Outurnate/tesla-coil/(list of files, cad)

Other CAD files:
model/primary_coil_form_b.scad
