Outurnate/tesla-coil/pcb/synth.kicad_pcb

## KiCad design pcb/synth.kicad_pcb (2023-07-12)

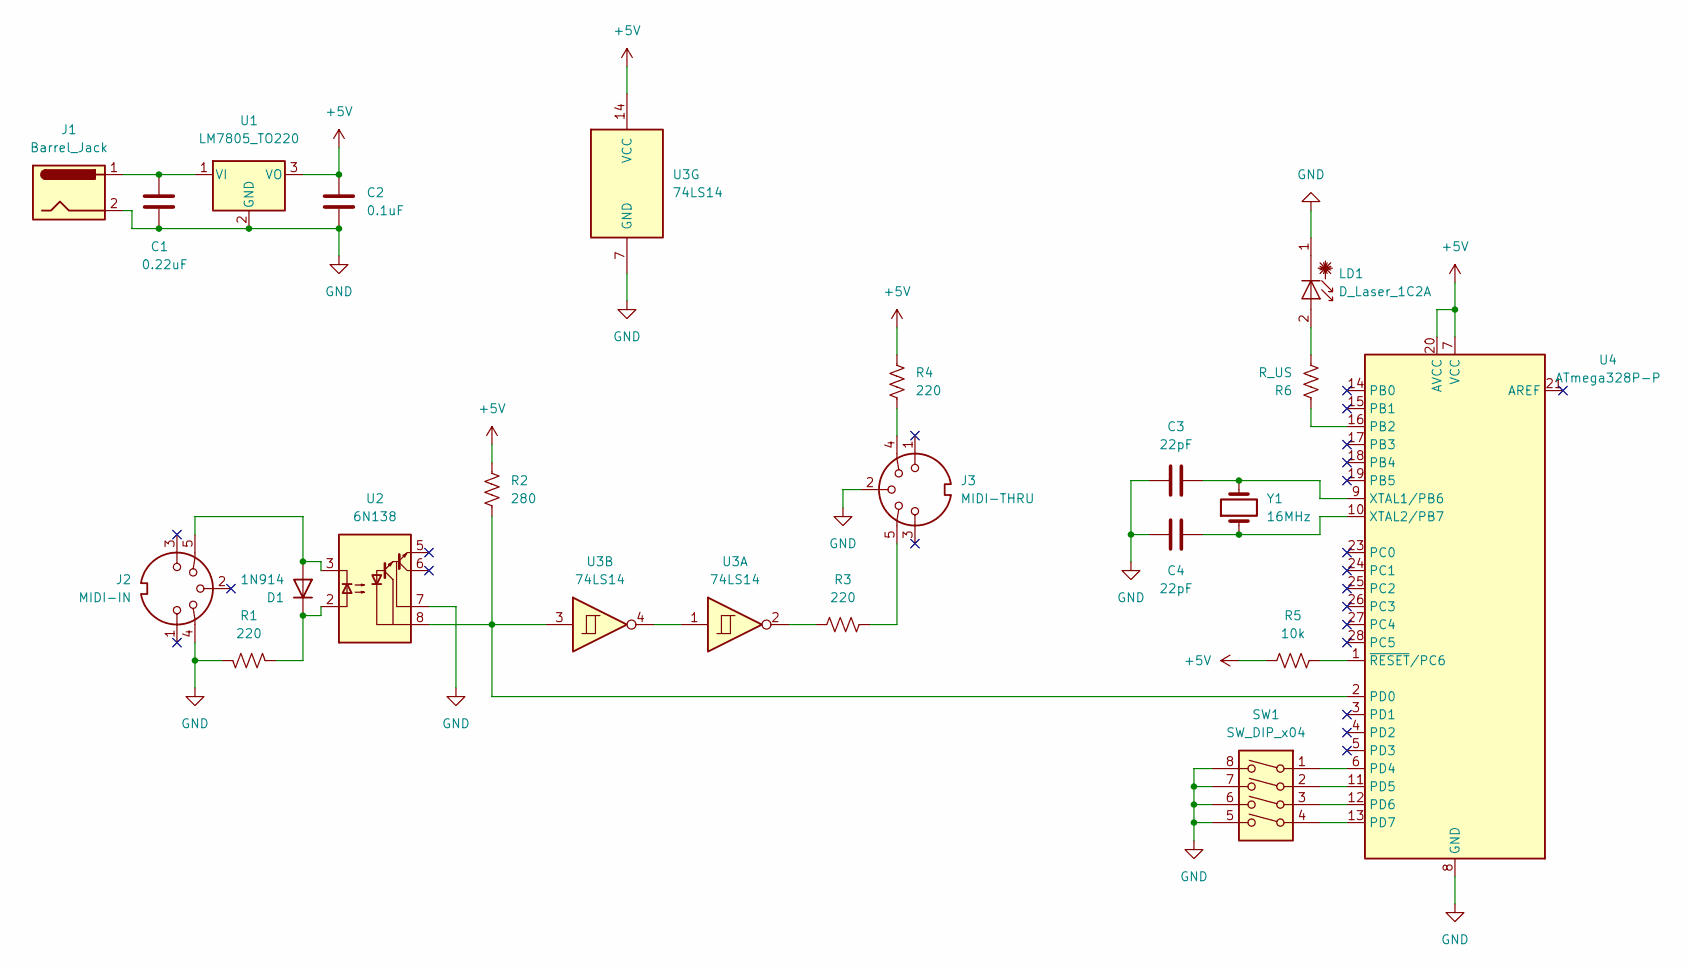
[picture p1: schematic synth.kicad_sch]

Parts:
C1: 0.22uF; C_Disc_D5.0mm_W2.5mm_P2.50mm
C2: 0.1uF; C_Disc_D5.0mm_W2.5mm_P2.50mm
C3, C4: 22pF; C_Disc_D5.0mm_W2.5mm_P2.50mm
D1: 1N914; D_DO-35_SOD27_P7.62mm_Horizontal
J1: Barrel_Jack; CUI_PJ-037A
J2: MIDI-IN; CUI_SDS-50J
J3: MIDI-THRU; CUI_SDS-50J
LD1: D_Laser_1C2A; PinHeader_1x02_P2.54mm_Vertical
R1, R3, R4: 220; R_Axial_DIN0207_L6.3mm_D2.5mm_P10.16mm_Horizontal
R2: 280; R_Axial_DIN0207_L6.3mm_D2.5mm_P10.16mm_Horizontal
R5: 10k; R_Axial_DIN0207_L6.3mm_D2.5mm_P10.16mm_Horizontal
R6: R_US; R_Axial_DIN0207_L6.3mm_D2.5mm_P10.16mm_Horizontal
SW1: SW_DIP_x04; SW_DIP_SPSTx04_Slide_9.78x12.34mm_W7.62mm_P2.54mm
U1: LM7805_TO220; TO-220-3_Vertical
U2: 6N138; DIP-8_W7.62mm_Socket
U3: 74LS14; DIP-14_W7.62mm_Socket
U4: ATmega328P-P; DIP-28_W7.62mm_Socket
Y1: 16MHz; Crystal_HC49-U_Vertical

Connections:
+5V: C2.1, R2.1, R4.1, R5.2, U1.3 (VO), U3.14 (VCC), U4.7 (VCC), U4.20 (AVCC)
GND: C1.2, C2.2, C3.2, C4.1, J1.2, J2.4, J3.2, LD1.1 (K), R1.2, SW1.5, SW1.6, SW1.7, SW1.8, U1.2 (GND), U2.7 (VO1), U3.7 (GND), U4.8 (GND), U4.22 (GND)
unnamed: C1.1, J1.1, U1.1 (VI)
unnamed: C3.1, U4.9 (XTAL1/PB6), Y1.2
unnamed: C4.2, U4.10 (XTAL2/PB7), Y1.1
unnamed: D1.1 (K), R1.1, U2.2 (C1)
unnamed: D1.2 (A), J2.5, U2.3 (C2)
unnamed: J3.4, R4.2
unnamed: J3.5, R3.1
unnamed: LD1.2 (A), R6.2
unnamed: R2.2, U2.8 (VCC), U3.3, U4.2 (PD0)
unnamed: R3.2, U3.2
unnamed: R5.1, U4.1 (~RESET/PC6)
unnamed: R6.1, U4.16 (PB2)
unnamed: SW1.1, U4.6 (PD4)
unnamed: SW1.2, U4.11 (PD5)
unnamed: SW1.3, U4.12 (PD6)
unnamed: SW1.4, U4.13 (PD7)
unnamed: U3.1, U3.4

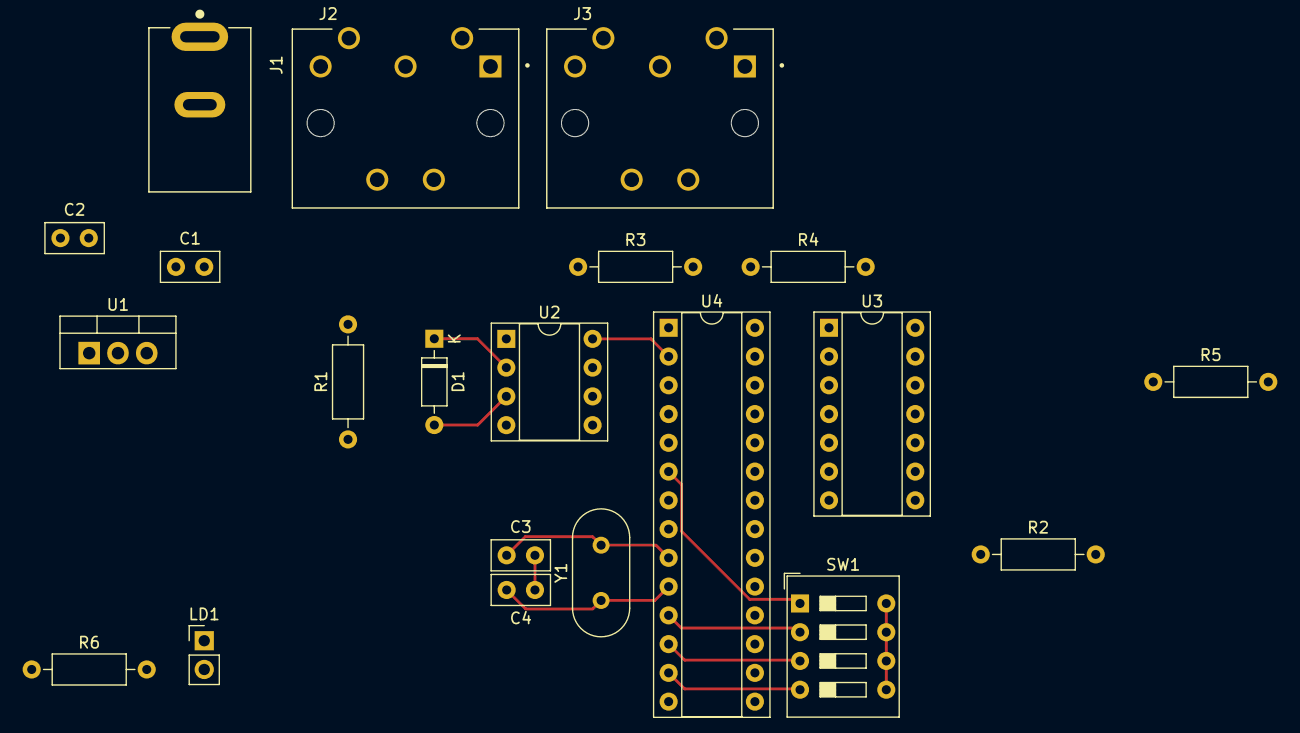
[picture p2: board synth.kicad_pcb from above]

Board: 2 copper layers, 21 parts (0 on the bottom side), 19 nets.
