Outurnate/tesla-coil/pcb/vdoubler.kicad_pcb

## KiCad design pcb/vdoubler.kicad_pcb (2023-07-12)

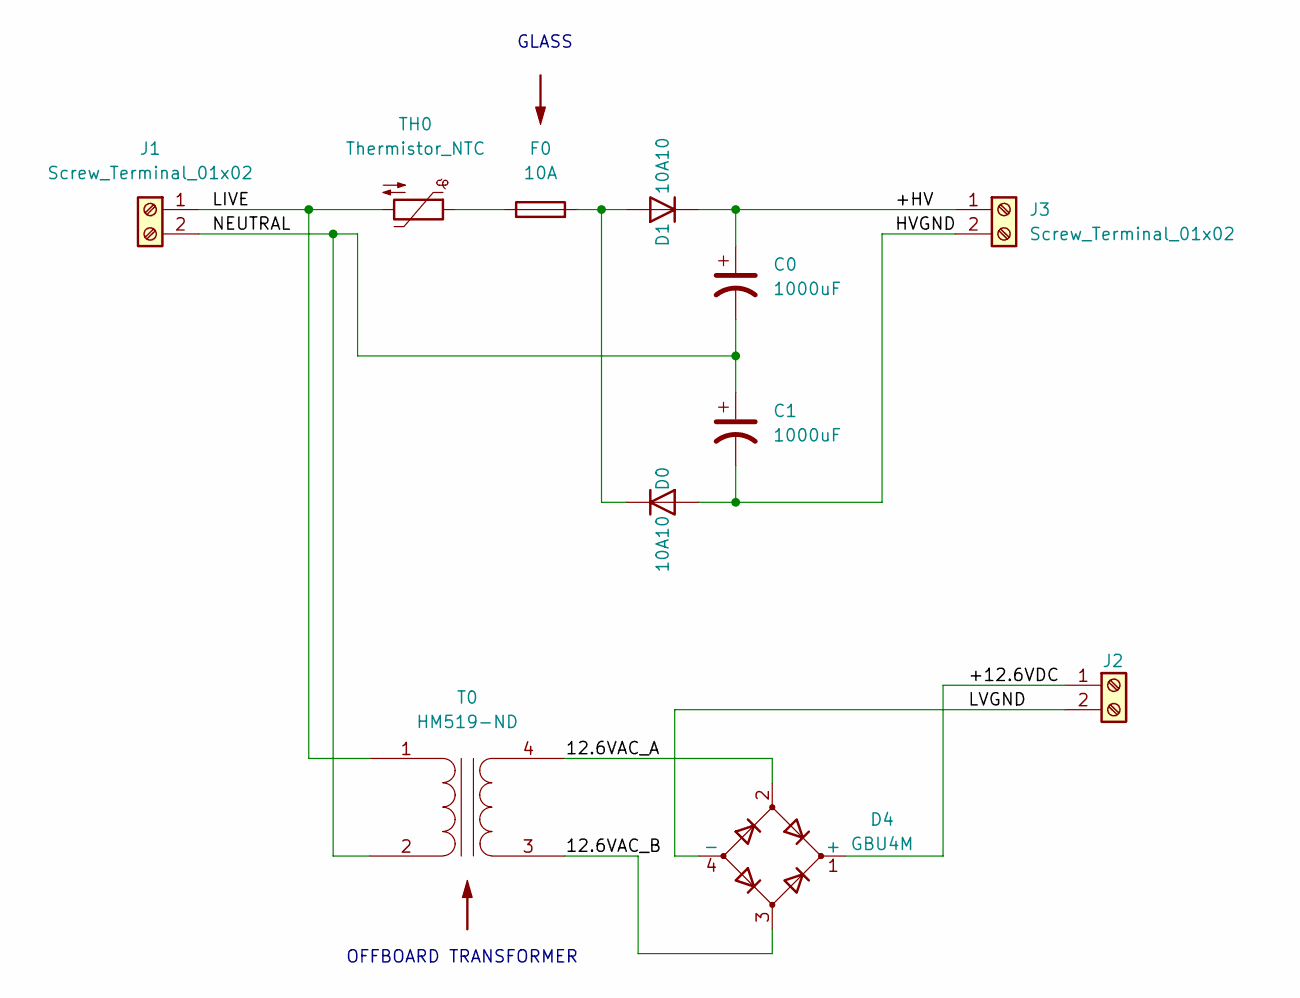
[picture p3: schematic vdoubler.kicad_sch]

Parts:
C0, C1: 1000uF; CP_Radial_D30.0mm_P10.00mm_SnapIn; DigiKey Part Number 399-ELH108M250AS5AA-ND
D0, D1: 10A10; D_P600_R-6_P12.70mm_Horizontal; DigiKey Part Number 3191-10A10-C1-3000-ND
D4: GBU4M; Diode_Bridge_Vishay_GBU; DigiKey Part Number GBU4M-ND
F0: 10A; Fuseholder_Cylinder-5x20mm_Bulgin_FX0456_Vertical_Closed; DigiKey Part Number 708-1427-ND
J1, J2, J3: Screw_Terminal_01x02; TE_1546833-2; DigiKey Part Number A112378-ND
T0: HM519-ND; TE_1546833-4; DigiKey Part Number HM519-ND
TH0: Thermistor_NTC; RV_Disc_D21.5mm_W4.3mm_P10mm; DigiKey Part Number 570-1354-ND

Connections:
/12.6VAC_A: D4.2, T0.4 (SB)
/12.6VAC_B: D4.3, T0.3 (SA)
/+12.6VDC: D4.1 (+), J2.1
/+HV: C0.1, D1.1 (K), J3.1
/HVGND: C1.2, D0.2 (A), J3.2
/LIVE: J1.1, T0.1 (AA), TH0.2
/LVGND: D4.4 (-), J2.2
/NEUTRAL: C0.2, C1.1, J1.2, T0.2 (AB)
unnamed: D0.1 (K), D1.2 (A), F0.2
unnamed: F0.1, TH0.1

Notes on the sheet:
GLASS
OFFBOARD TRANSFORMER

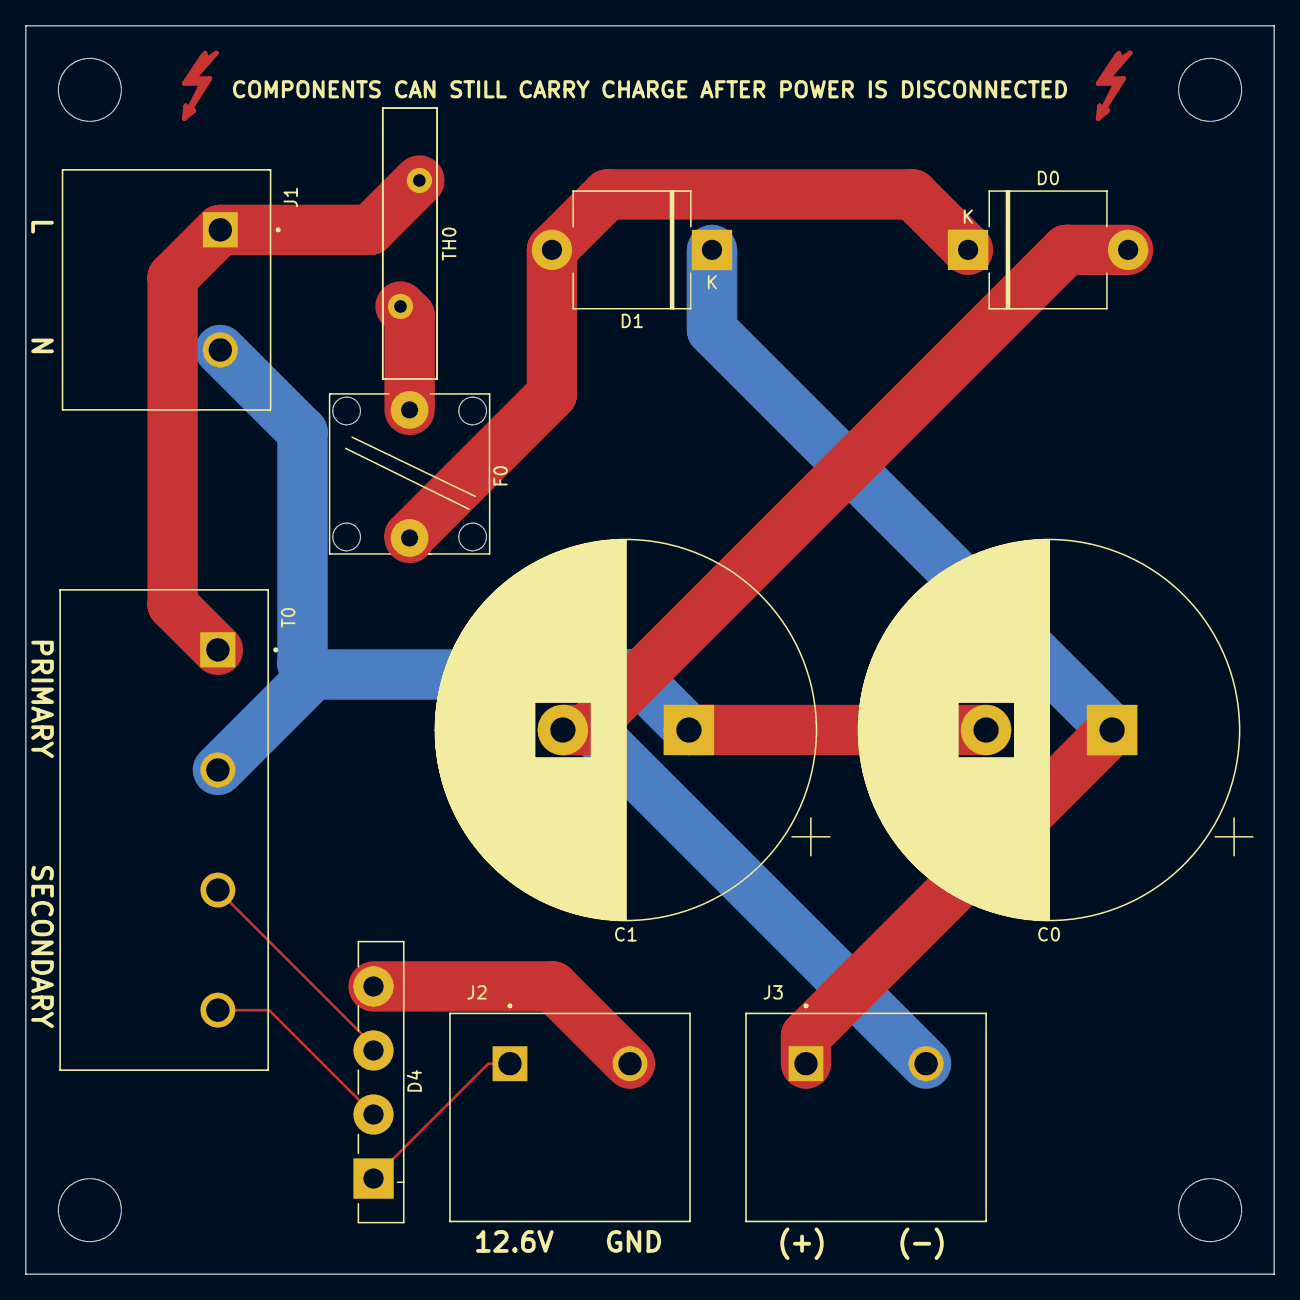
[picture p4: board vdoubler.kicad_pcb from above]

Board: 2 copper layers, 99.1 x 99.1 mm, 11 parts (0 on the bottom side), 10 nets.
