Outurnate/tesla-coil/pcb/driver.kicad_pcb

## KiCad design pcb/driver.kicad_pcb (2023-07-12)

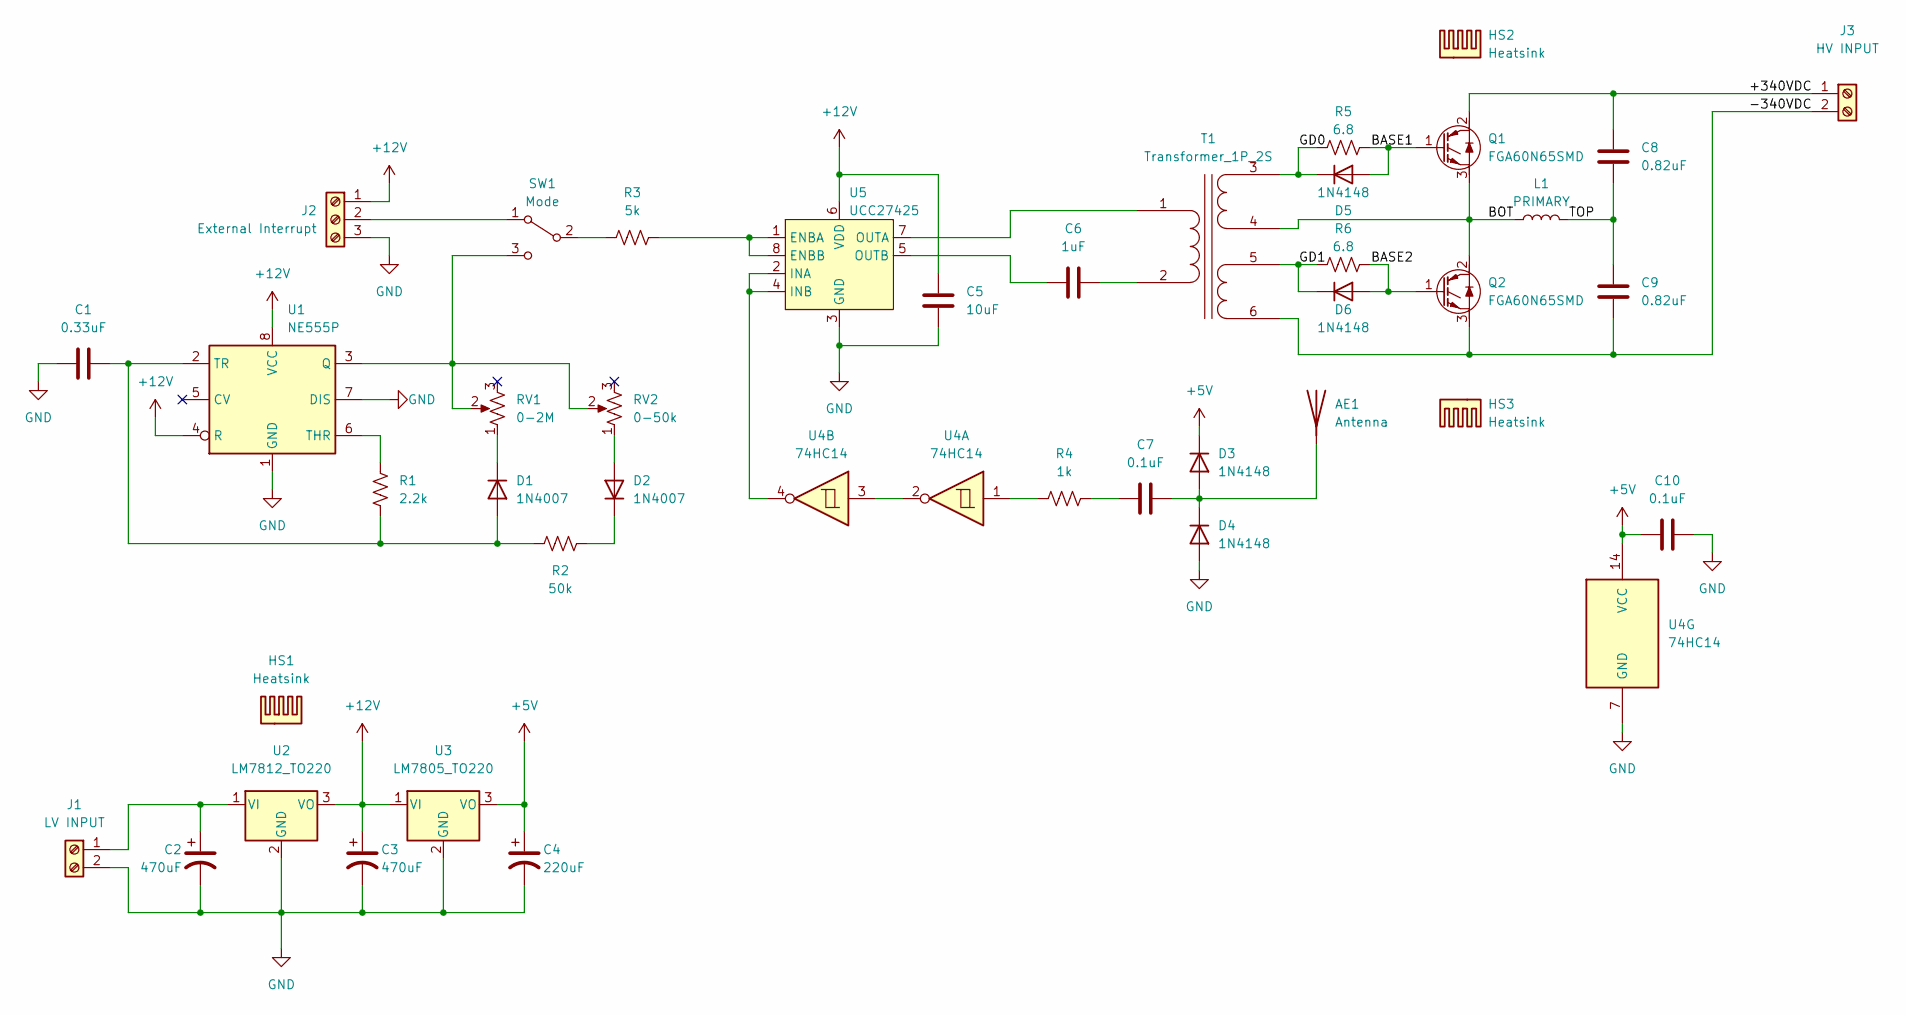
[picture p5: schematic driver.kicad_sch]

Parts:
AE1: Antenna; PinHeader_1x01_P2.54mm_Vertical
C1: 0.33uF; C_Rect_L7.0mm_W3.5mm_P5.00mm; DigiKey Part Number 445-180638-1-ND
C2, C3: 470uF; CP_Radial_D10.0mm_P5.00mm; DigiKey Part Number 1189-1869-ND
C4: 220uF; CP_Radial_D8.0mm_P3.50mm; DigiKey Part Number 732-8829-1-ND
C5: 10uF; C_Rect_L7.0mm_W3.5mm_P5.00mm; DigiKey Part Number 445-FG26X7R1E106KRT00-ND
C6: 1uF; C_Rect_L7.0mm_W3.5mm_P5.00mm; DigiKey Part Number 445-FG24X7R1H105KRT00-ND
C7, C10: 0.1uF; C_Rect_L11.0mm_W2.8mm_P10.00mm_MKT; DigiKey Part Number 1572-1638-ND
C8, C9: 0.82uF; C_Rect_L16.5mm_W4.9mm_P15.00mm_MKT; DigiKey Part Number P122566-ND
D1, D2: 1N4007; D_DO-41_SOD81_P10.16mm_Horizontal; DigiKey Part Number 1N4007GDICT-ND
D3, D4, D5, D6: 1N4148; D_DO-35_SOD27_P7.62mm_Horizontal; DigiKey Part Number 1N4148FS-ND
HS1: Heatsink; DigiKey Part Number A10755-ND
HS2, HS3: Heatsink; DigiKey Part Number 102-4229-ND
J1: LV INPUT; TE_1546833-2; DigiKey Part Number A112378-ND
J2: External Interrupt; 282834-3; DigiKey Part Number A98334-ND
J3: HV INPUT; TE_1546833-2; DigiKey Part Number A112379-ND
L1: PRIMARY; TE_1546833-2; DigiKey Part Number A112378-ND
Q1, Q2: FGA60N65SMD; TO-3P-3_Vertical_Heatsink; DigiKey Part Number FGA60N65SMDFS-ND
R1: 2.2k; R_Axial_DIN0207_L6.3mm_D2.5mm_P7.62mm_Horizontal; DigiKey Part Number CF14JT2K20TR-ND
R2: 50k; R_Axial_DIN0207_L6.3mm_D2.5mm_P10.16mm_Horizontal; DigiKey Part Number RN60C5002DB14-ND
R3: 5k; R_Axial_DIN0207_L6.3mm_D2.5mm_P7.62mm_Horizontal; DigiKey Part Number BC4514CT-ND
R4: 1k; R_Axial_DIN0207_L6.3mm_D2.5mm_P7.62mm_Horizontal
R5, R6: 6.8; R_Axial_DIN0207_L6.3mm_D2.5mm_P10.16mm_Horizontal; DigiKey Part Number 2019-MOSX1CT528R6R8JCT-ND
RV1: 0-2M; 282834-2; DigiKey Part Number A98333-ND
RV2: 0-50k; 282834-2; DigiKey Part Number A98333-ND
SW1: Mode; 282834-3; DigiKey Part Number A98334-ND
T1: Transformer_1P_2S; GDT; DigiKey Part Number 1934-1153-ND
U1: NE555P; DIP-8_W7.62mm; DigiKey Part Number 296-NE555P-ND
U2: LM7812_TO220; TO-220-3_Vertical; DigiKey Part Number MC7812ACTGOS-ND
U3: LM7805_TO220; TO-220-3_Vertical; DigiKey Part Number MC7805CTGOS-ND
U4: 74HC14; DIP-8_W7.62mm
U5: UCC27425; DIP-8_W7.62mm; DigiKey Part Number 296-1577-5-ND

Connections:
+5V: C4.1, C10.1, D3.1 (K), U3.3 (VO), U4.14 (VCC)
+12V: C3.1, C5.1, J2.1, U1.4 (R), U1.8 (VCC), U2.3 (VO), U3.1 (VI), U5.6 (VDD)
/+340VDC: C8.1, J3.1, Q1.2 (C)
/-340VDC: C9.2, J3.2, Q2.3 (E), T1.6 (SD)
/BASE1: D5.2 (A), Q1.1 (G), R5.1
/BASE2: D6.2 (A), Q2.1 (G), R6.1
/BOT: L1.1, Q1.3 (E), Q2.2 (C), T1.4 (SB)
/GD0: D5.1 (K), R5.2, T1.3 (SA)
/GD1: D6.1 (K), R6.2, T1.5 (SC)
/TOP: C8.2, C9.1, L1.2
GND: C1.2, C2.2, C3.2, C4.2, C5.2, C10.2, D4.2 (A), J1.2, J2.3, U1.1 (GND), U1.7 (DIS), U2.2 (GND), U3.2 (GND), U4.7 (GND), U5.3 (GND)
unnamed: AE1.1 (A), C7.2, D3.2 (A), D4.1 (K)
unnamed: C7.1, R4.1
unnamed: C1.1, D1.2 (A), R1.2, R2.2, U1.2 (TR)
unnamed: D1.1 (K), RV1.1
unnamed: D2.2 (A), RV2.1
unnamed: D2.1 (K), R2.1
unnamed: C2.1, J1.1, U2.1 (VI)
unnamed: J2.2, SW1.1 (A)
unnamed: R4.2, U4.1
unnamed: R3.2, SW1.2 (B)
unnamed: RV1.2, RV2.2, SW1.3 (C), U1.3 (Q)
unnamed: T1.1 (AA), U5.7 (OUTA)
unnamed: C6.1, T1.2 (AB)
unnamed: R1.1, U1.6 (THR)
unnamed: U4.2, U4.3
unnamed: R3.1, U5.1 (ENBA), U5.8 (ENBB)
unnamed: U4.4, U5.2 (INA), U5.4 (INB)
unnamed: C6.2, U5.5 (OUTB)

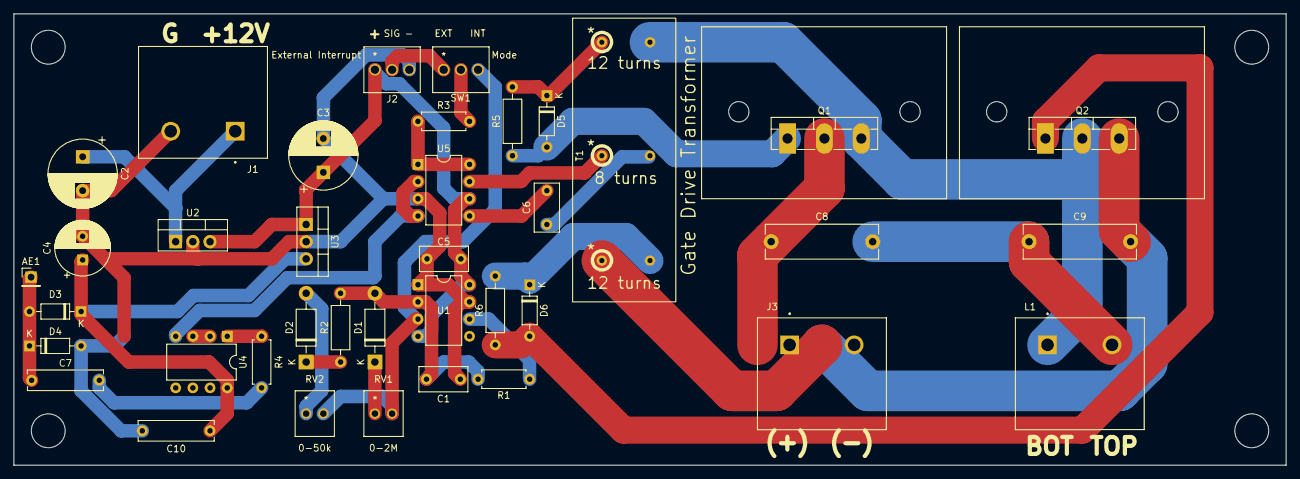
[picture p6: board driver.kicad_pcb from above]

Board: 2 copper layers, 188.0 x 66.7 mm, 38 parts (0 on the bottom side), 29 nets.
